foss-wales/farmhack-watering-system/Moisture Sensor Docs/Bodenfeuchte Sensor Modul Raspberry Pi Schematic.pdf

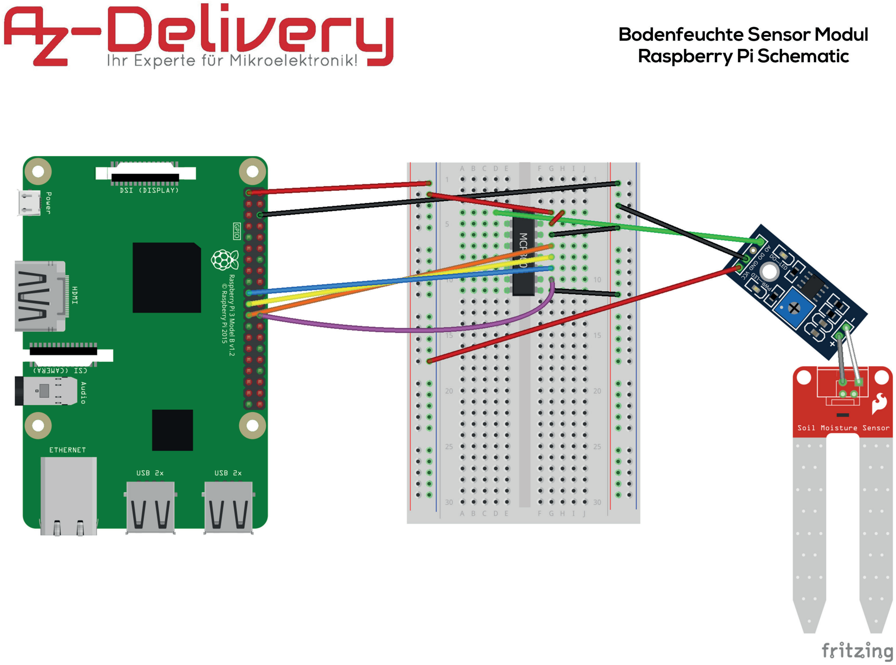
[picture p3: page 1]
