foss-wales/farmhack-watering-system/(commit log)

2023-10-07 link valve
2023-10-07 document valve and lh293d
2023-10-07 Switch valve on and off each second
2023-10-07 Rad sensor and switch valve on and off
2023-10-07 Only switch the valve when the state of it changes
2023-10-08 Change watering system to use top and low value for switching on and off the watering according to the state
2023-10-08 Adding Docs for Moisture Sensor
2023-10-08 add arduino IDE link
2024-03-18 Update README.md
    Added moisture sensor details
